Eldinox/Mosy_FreeRide_python/Kamerakopf und Arme korrekt.stl

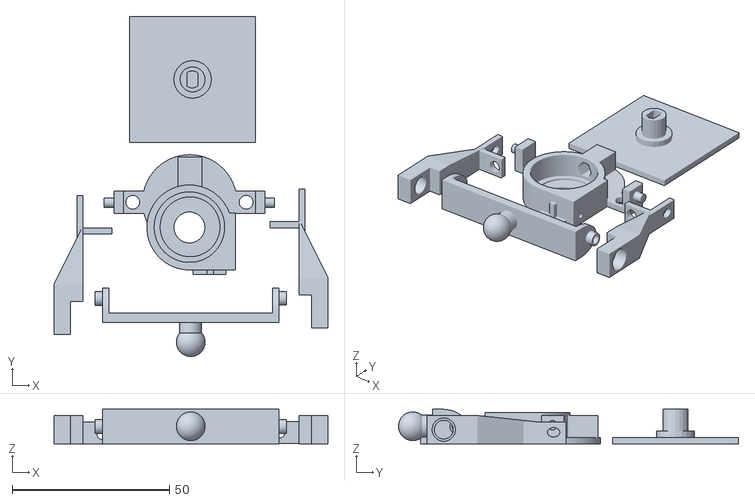
[picture p6: CAD file, 2018-07-19]
Kamerakopf und Arme korrekt.stl
87.0 x 108.0 x 11.0
